hvak/SNACBot/snacbot_description/meshes/hand_link_1.stl

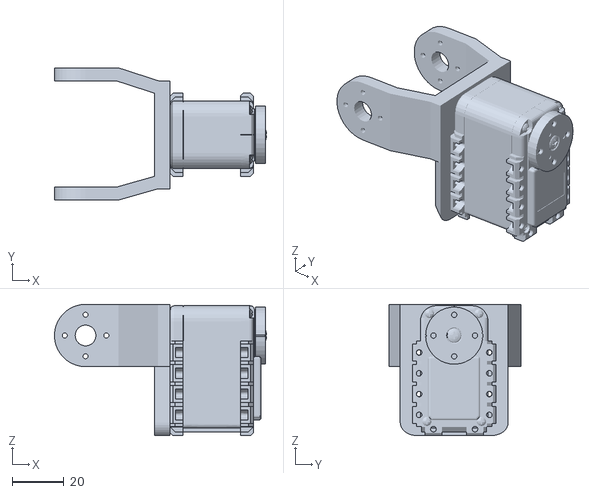
[picture p11: CAD file, 2022-04-07]
snacbot_description/meshes/hand_link_1.stl
81.6 x 50.8 x 50.5
