hvak/SNACBot/snacbot_description/meshes/gripper_driving_link_1.stl

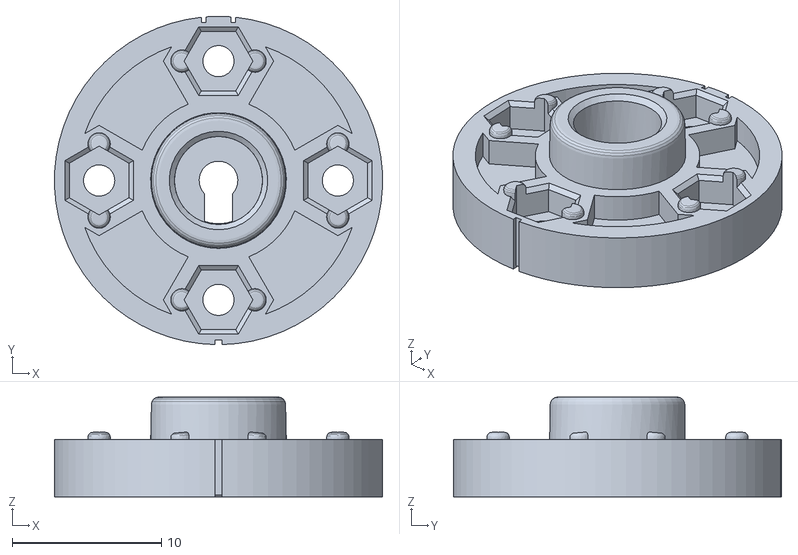
[picture p12: CAD file, 2022-04-07]
snacbot_description/meshes/gripper_driving_link_1.stl
22.0 x 22.0 x 6.70
