hvak/SNACBot/snacbot_description/meshes/finger2_link_1.stl

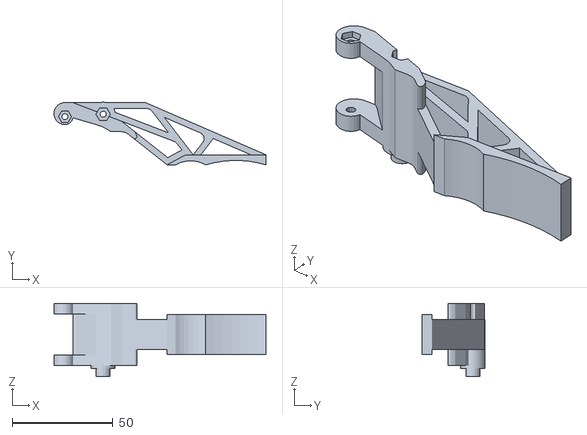
[picture p13: CAD file, 2022-04-07]
snacbot_description/meshes/finger2_link_1.stl
105.5 x 31.2 x 36.5
