hvak/SNACBot/snacbot_description/meshes/base_link.stl

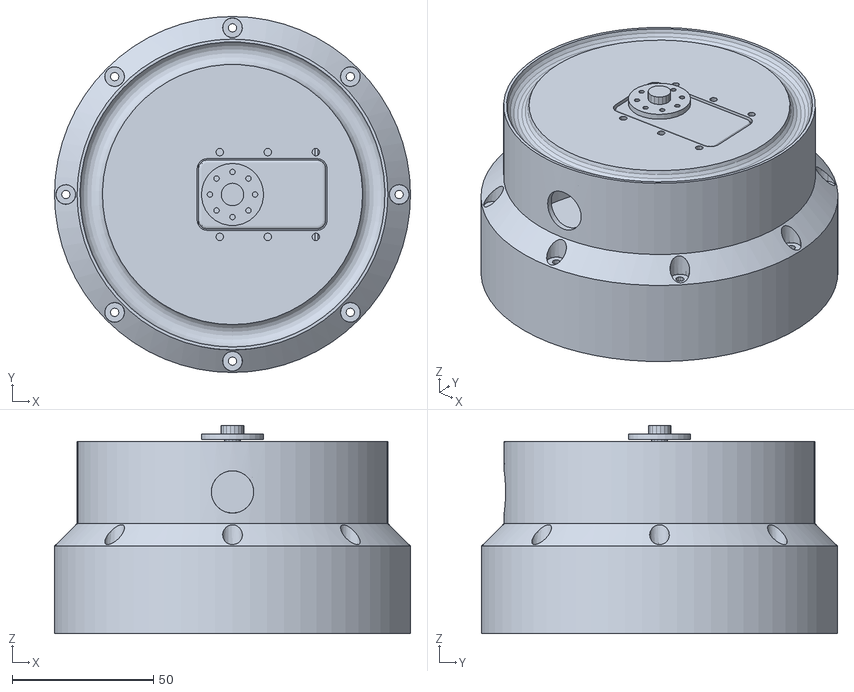
[picture p14: CAD file, 2022-04-07]
snacbot_description/meshes/base_link.stl
126.0 x 126.0 x 73.7
