hvak/SNACBot/snacbot_description/meshes/forearm_link_1.stl

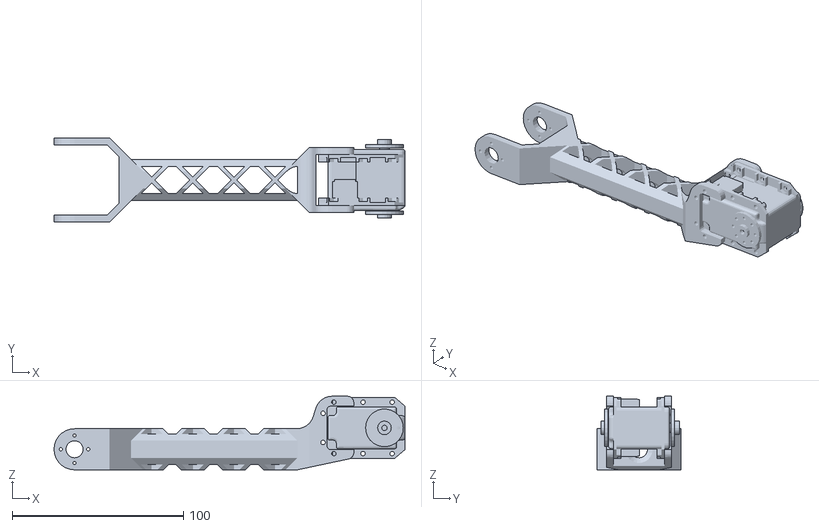
[picture p15: CAD file, 2022-04-07]
snacbot_description/meshes/forearm_link_1.stl
204.8 x 49.0 x 43.0
