hvak/SNACBot/snacbot_description/meshes/arm_link_1.stl

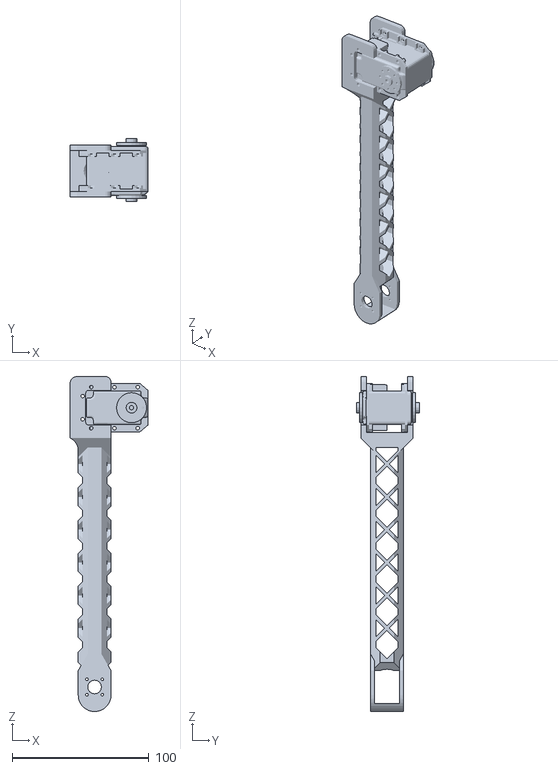
[picture p16: CAD file, 2022-04-07]
snacbot_description/meshes/arm_link_1.stl
57.0 x 45.8 x 244.9
