hvak/SNACBot/snacbot_description/meshes/shoulder_link_1.stl

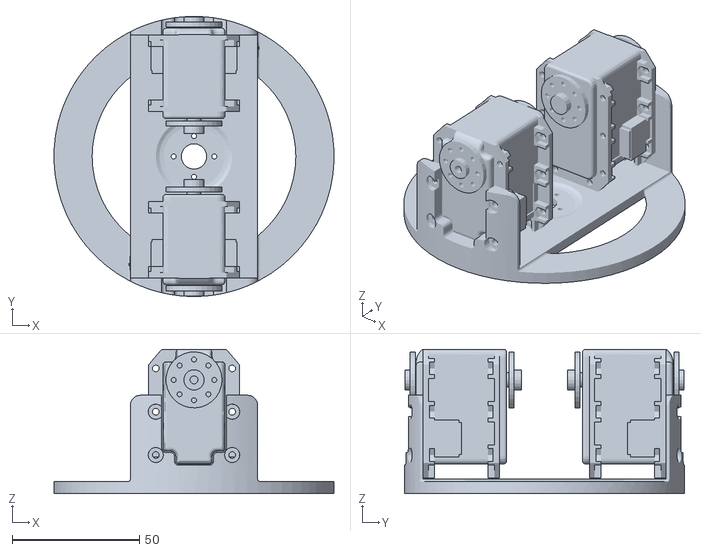
[picture p17: CAD file, 2022-04-07]
snacbot_description/meshes/shoulder_link_1.stl
110.0 x 110.0 x 56.7
