hvak/SNACBot/snacbot_description/meshes/palm_link_1.stl

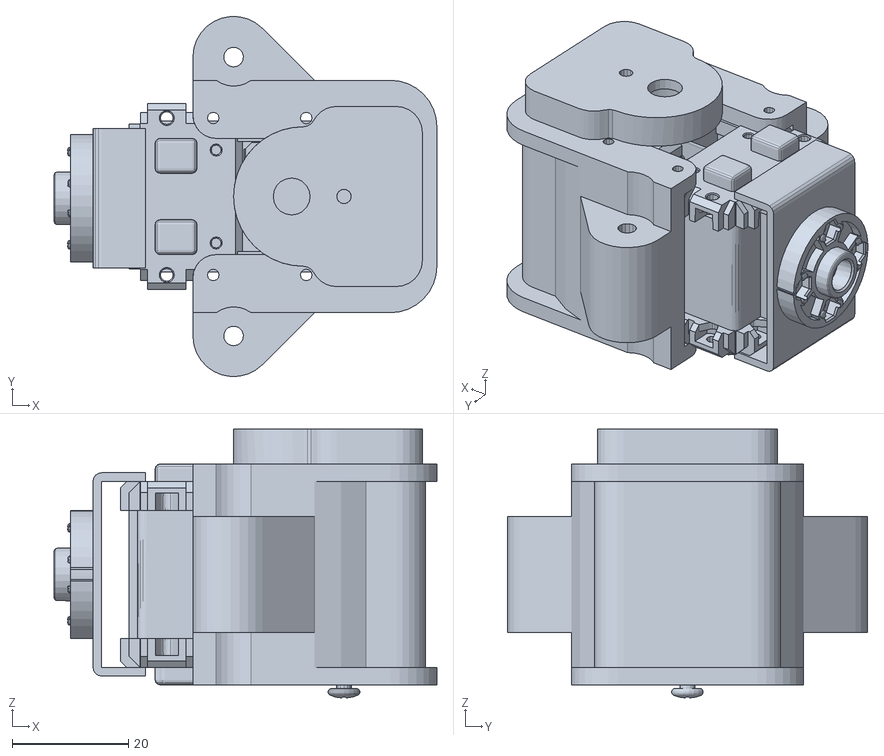
[picture p18: CAD file, 2022-04-07]
snacbot_description/meshes/palm_link_1.stl
65.9 x 62.0 x 46.2
