hvak/SNACBot/(list of files, cad)

Other CAD files:
snacbot_description/meshes/finger1_link_1.stl
