hvak/SNACBot/snacbot_description/launch/controller.yaml

snacbot3_urdf_controller:
  # Publish all joint states -----------------------------------
  joint_state_controller:
    type: joint_state_controller/JointStateController
    publish_rate: 50

  # Position Controllers --------------------------------------
  waist_joint_position_controller:
    type: effort_controllers/JointPositionController
    joint: waist_joint
    pid: {p: 100.0, i: 0.01, d: 10.0}
  shoulder_joint_position_controller:
    type: effort_controllers/JointPositionController
    joint: shoulder_joint
    pid: {p: 100.0, i: 0.01, d: 10.0}
  elbow_joint_position_controller:
    type: effort_controllers/JointPositionController
    joint: elbow_joint
    pid: {p: 100.0, i: 0.01, d: 10.0}
  wrist_joint_position_controller:
    type: effort_controllers/JointPositionController
    joint: wrist_joint
    pid: {p: 100.0, i: 0.01, d: 10.0}
  palm_joint_position_controller:
    type: effort_controllers/JointPositionController
    joint: palm_joint
    pid: {p: 100.0, i: 0.01, d: 10.0}
  gripper_joint_position_controller:
    type: effort_controllers/JointPositionController
    joint: gripper_joint
    pid: {p: 100.0, i: 0.01, d: 10.0}
  finger1_joint_position_controller:
    type: effort_controllers/JointPositionController
    joint: finger1_joint
    pid: {p: 100.0, i: 0.01, d: 10.0}
  finger2_joint_position_controller:
    type: effort_controllers/JointPositionController
    joint: finger2_joint
    pid: {p: 100.0, i: 0.01, d: 10.0}
