hvak/SNACBot/snacbot_moveit/config/joint_limits.yaml

# joint_limits.yaml allows the dynamics properties specified in the URDF to be overwritten or augmented as needed

# For beginners, we downscale velocity and acceleration limits.
# You can always specify higher scaling factors (<= 1.0) in your motion requests.  # Increase the values below to 1.0 to always move at maximum speed.
default_velocity_scaling_factor: 1.0
default_acceleration_scaling_factor: 1.0

# Specific joint properties can be changed with the keys [max_position, min_position, max_velocity, max_acceleration]
# Joint limits can be turned off with [has_velocity_limits, has_acceleration_limits]
joint_limits:
  elbow_joint:
    has_velocity_limits: true
    max_velocity: 5.0
    has_acceleration_limits: false
    max_acceleration: 0
  finger1_joint:
    has_velocity_limits: false
    max_velocity: 0.0
    has_acceleration_limits: false
    max_acceleration: 0
  finger2_joint:
    has_velocity_limits: false
    max_velocity: 0.0
    has_acceleration_limits: false
    max_acceleration: 0
  gripper_joint:
    has_velocity_limits: true
    max_velocity: 5.0
    has_acceleration_limits: false
    max_acceleration: 0
  palm_joint:
    has_velocity_limits: true
    max_velocity: 5.0
    has_acceleration_limits: false
    max_acceleration: 0
  shoulder_joint:
    has_velocity_limits: true
    max_velocity: 5.0
    has_acceleration_limits: false
    max_acceleration: 0
  waist_joint:
    has_velocity_limits: true
    max_velocity: 5.0
    has_acceleration_limits: false
    max_acceleration: 0
  wrist_joint:
    has_velocity_limits: true
    max_velocity: 5.0
    has_acceleration_limits: false
    max_acceleration: 0
