hvak/SNACBot/(commit log)

2022-04-07 added joint limits for arm group
    [snacbot.urdf, snacbot.xacro]
2022-04-08 working gripper
    [ros_controllers.yaml, snacbot.urdf, snacbot.xacro]
2022-04-09 added moveit_interface, minor fixes and changes
    [arm.yaml]
2022-04-10 ikfast testing
    [snacbot_ik.urdf]
2022-04-12 added pid gains for motors
2022-04-13 smoothing arm movement
    [joint_limits.yaml]
2022-04-13 added realsense to urdf
    [snacbot.urdf, snacbot.xacro]
2022-04-13 urdf realsense fix
    [snacbot.urdf]
2022-04-14 updated urdf with new base and colors
    [materials.xacro, snacbot.urdf, snacbot.xacro, snacbot_ik.urdf]
2022-04-14 update ikfast for new urdf
2022-04-14 sleep state and torque changes
2022-04-14 Added a function to compute some info for a gripper pose
2022-04-14 add way to open gripper to a distance
2022-04-15 Fixed the gripper position script
2022-04-17 update urdf
    [snacbot.urdf, snacbot.xacro, snacbot_ik.urdf]
2022-04-17 updated kinematics for new joint limits
2022-04-17 clamp waist rotation value
